yasserqureshi1/ES2C6-Self-Balancing-Robot/Design Project Self Balancing Robot - Group 3.pdf

## ES2C6 Design Project

# Self-Balancing Robot

## Group 3

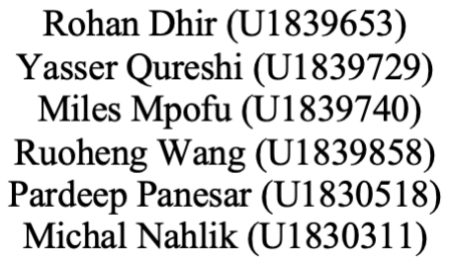
[picture p1: figure]
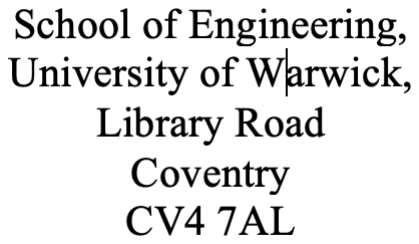
[picture p2: figure]

## December 2019

Table of Contents

## 1. Introduction

1.1Mandate

Our task: design a low cost self-balancing robot which met the following criteria:

1. The ability to balance on both wheels for a minimum of 10 seconds
2. The ability to be fit in our storage box (dimensions 105 x 170 x 295mm) with the wheels removed
3. Can be safely deployed (i.e. not to cause harm by being unstable)
4. Not include any Arduino libraries

1.2Group Aims

1. Innovative design: build on previous successes, adding new features, design and code improvements.
2. Use of Theory: learnt in lectures and additional theories such as the ‘inverted pendulum’.

## 2. Theory

### 2.1 Inverted Pendulum

Our robot was designed with an ‘Inverted Pendulum’ in mind. This describes a system, where an inverted pendulum has to be maintained upright by moving the cart under its centre of mass.

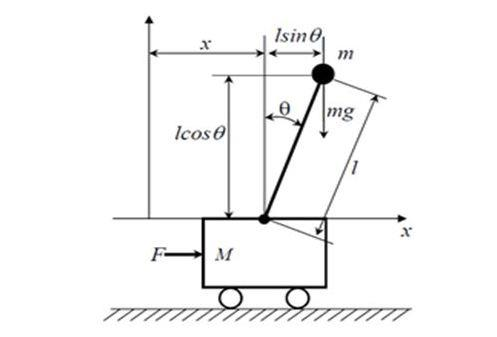
[picture p3: figure]

Figure 1 Theoretical diagram of Self-Balancing Robot

In this system, the pendulum has its centre of mass above the pivot point. The system is naturally unstable and without any help will fall over. In our case the system is a large mass at the end of a pole. The pole is free to rotate around its base, which itself moves in a horizontal plane, perpendicular to the vertical plane of the mass and pole. In the system above, when the pole is offset from its centre point, for example to the left of it, the cart must move to the left to re-centre the centre of mass.

To achieve a state of equilibrium we must control and stabilize the direction and acceleration of the robot. The motion of the robot will depend on the direction of rotation of the wheels and the acceleration will depend upon the angular acceleration of the wheels. Central to balancing our robot is measuring tilt using the IMU, using this feedback to implement closed-loop control. To optimize balance, the centre of mass should be higher relative to the wheel axles since this corresponds to lower angular acceleration and hence slower fall.

2.2Techniques of Sensor Uses

1. Accelerometer: Gives acceleration in multiple axis; x and y calculated using the equation: θ = arctan (Ay/Ax ). However, noise means this method is likely inaccurate.
2. Gyrometer: Calculates the angular velocities across axis. Sometimes has low frequency noise which mean that values are completely wrong.
3. Gyrometer and Accelerometer: Data from both are obtained in an MPU6050 and fused using either a Kalman or a Complementary Filter, resulting in an improvement in the results of both sensors.

2.3DC Motor

DC motors act as continuous actuators to balance the robot, converting electrical energy into mechanical energy through continuous angular rotation to rotate the wheels.

2.4H-Bridge

A H-Bridge controls the direction of the DC motors by switching the polarity of the voltage applied to the load, allowing the motors to run forward or backward.

The H-bridge has four switches, allowing control of the voltage direction. When switches S1 and S4 are closed and S2 and S3 open, a positive voltage is applied across the motor and vice versa to produce a negative voltage.

2.5PID Control

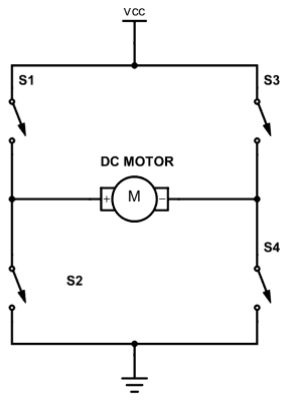
[picture p4: figure]

A PID controller sets the speed of the motors depending on the angle of inclination. It continuously calculates an error value e(t) as the difference between the desired set point and measured process variable and corrects the error based on proportional, integral and derivative terms below:

P: Accounts for present values of the error. For example, if the error is large and positive the control output will also be large and positive.
I: Accounts for past values of the error.
D: Accounts for possible future trends of the error, based on its current rate of change.

The formula using these parameters for PID is below with KP, KI

, KD as non-negative
parameters.
u(t) = KPe(t) + KI ∫ e(t)dt + KP

de
dt

Figure 2 H-Bridge diagram

## 3. Components

3.1List of Components

Table 1

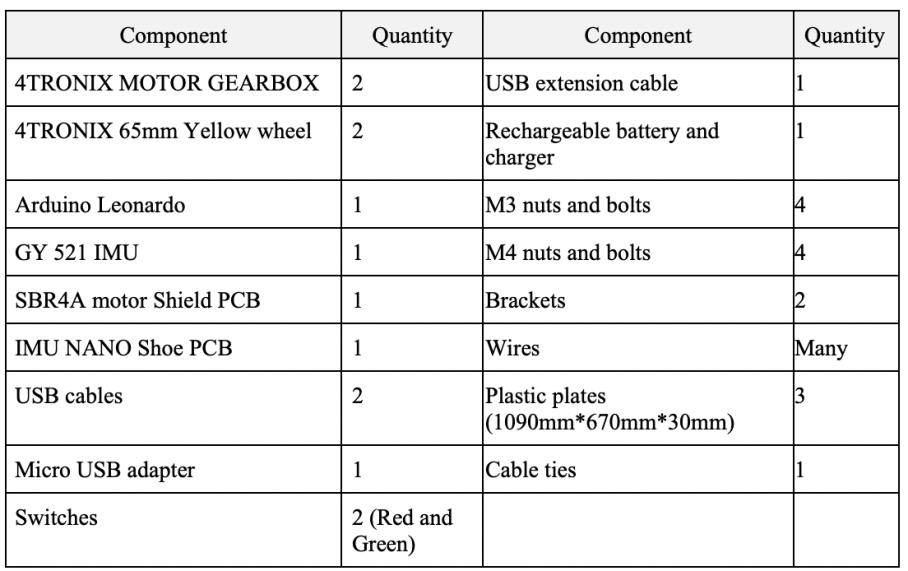
[picture p5: figure]

3.2Components

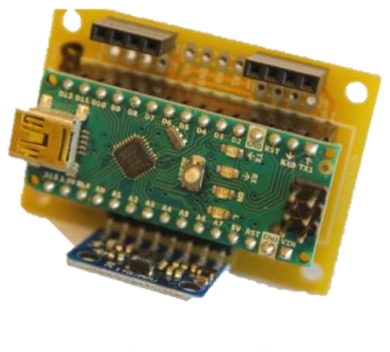
[picture p6: figure]

Figure 3 Accelerometer and Gyroscope

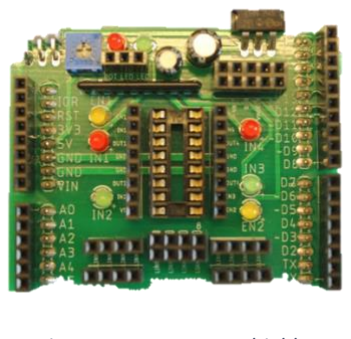
[picture p7: figure]

Figure 4 Motor Protoshield

## 4. Initial Design and Ideas

We initially considered several designs, taking theory into account and focused on creating a feasible yet innovative design.

Our structure was initially divided into 3 layers, with each layer holding a single component, using glue. However, according to the 40 design principles, glue isn’t easy to disassemble, making the entire assembly "one-off", which is not ideal in case of any modification, damage or battery replacement. Therefore, we decided to use fastenings such as nuts, bolts and screws instead, so that we did not compromise on a secure fit.

We used aluminium as the main material for our structure due to its availability as well as its material properties such as its toughness, hardness and rigidity, which would minimise rattling and damage.

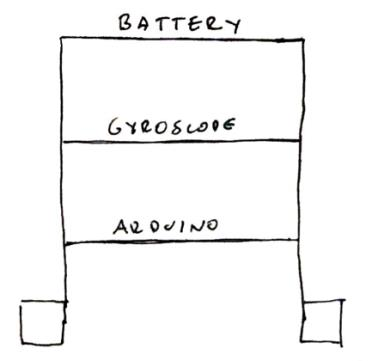
[picture p8: figure]

Figure 5 Initial Design

## 5. Design Improvements and Iterations

Initially, the robot incorporated two horizontal plates mounted on an aluminium tubed design, due to its equal distribution of mass over the axis of rotation. We learned in order to get more accurate accelerometer readings the accelerometer would have to be mounted vertically. As a result, we were forced to rethink our design.

We realised that it would be more efficient to mount the components vertically rather than horizontally as the robot would be more compact and better shielded against damage as well as provide better accessibility and protection. We also designed and printed a 3D plate to hold the battery over the centre of mass. This first iteration was later adjusted to account for switch holders.

During our testing process, we felt our robot was too unstable to function with our Arduino code. We felt that this may be due to the weight distribution of the robot. Although theory tells us that a robot with a higher centre of mass balances better, we sought to remove any excess space between components and trim the length of the aluminium rods by 4cm. This had the immediate effect of a better performing structure.

## 6. Assembly Process

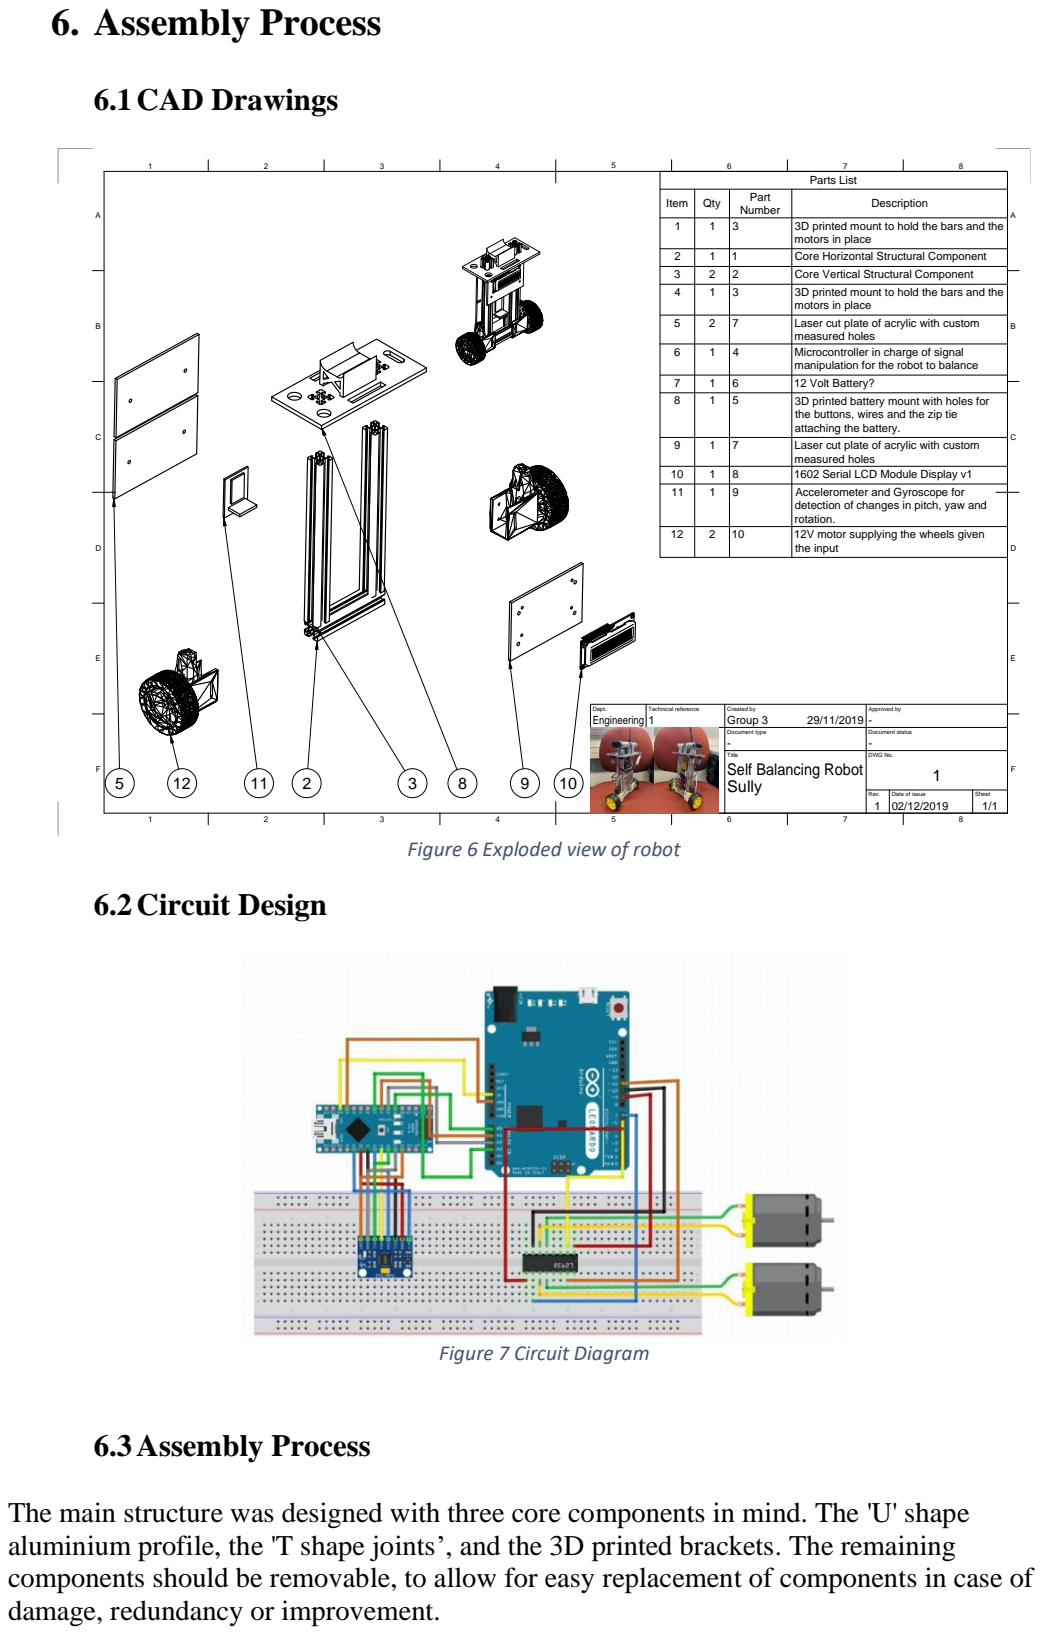
[picture p9: page 7]
6.1CAD Drawings; 6.2Circuit Design; 6.3Assembly Process; Dept.; Technical reference; Created by; Approved by; Document type; Document status; Title; DWG No.; Rev.; Date of issue; Sheet 1 02/12/2019; Sully; 1 Self Balancing Robot; Engineering 1; Group 3; Parts List; Item; Qty; Part Number; Description; 3D printed mount to hold the bars and the motors in place; Core Horizontal Structural Component; Core Vertical Structural Component; Laser cut plate of acrylic with custom; measured holes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

the buttons, wires and the zip tie
attaching the battery.

Figure 6 Exploded view of robot

Figure 7 Circuit Diagram

The main structure was designed with three core components in mind. The 'U' shape
aluminium profile, the 'T shape joints’, and the 3D printed brackets. The remaining
components should be removable, to allow for easy replacement of components in case of
damage, redundancy or improvement.

The U shape is held in place using ‘T-shape joints’ on the rails on the aluminium profiles. Similarly, the acrylic pieces are held together using the rails on the ‘aluminium extrusion bars’ using the ‘t shape joints’ with 4mm screws.

The robot design allows for easy part removal to work on changes and improvements. This was crucial when there were design flaws with the acrylic plates, and we could replace individual plates without disassembling the entire robot. We endeavoured to make the robot as easy to customise as possible. To this effect, we attached the Leonardo plastic motor shield to the structure instead of the Arduino ensuring the Arduino could be easily mounted and unmounted.

## 7. Code and Testing

7.1MPU6050 Testing

The sensor was tested to determine the format of the data and if it functioned as expected. This involves reading values from the GY521 accelerometer and gyroscope. There are 4 different values: yaw, roll, pitch and whether it’s balanced (known as the UP pin)

To read data, the following code is used:

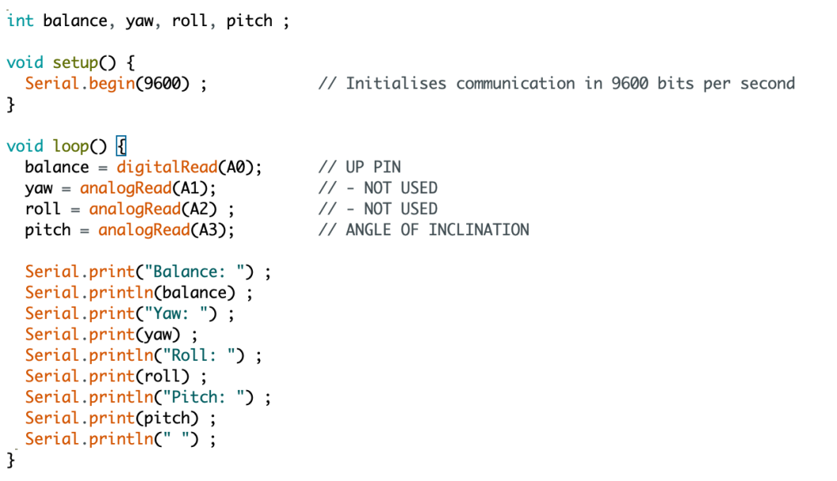
[picture p10: figure]

7.2DC Motor Testing

Prior to any development of PID, tests were conducted as below to determine whether the wheels functioned as expected. Each motor has 3 pins: two inputs (‘INs’) and an enable (‘EN’) pin.

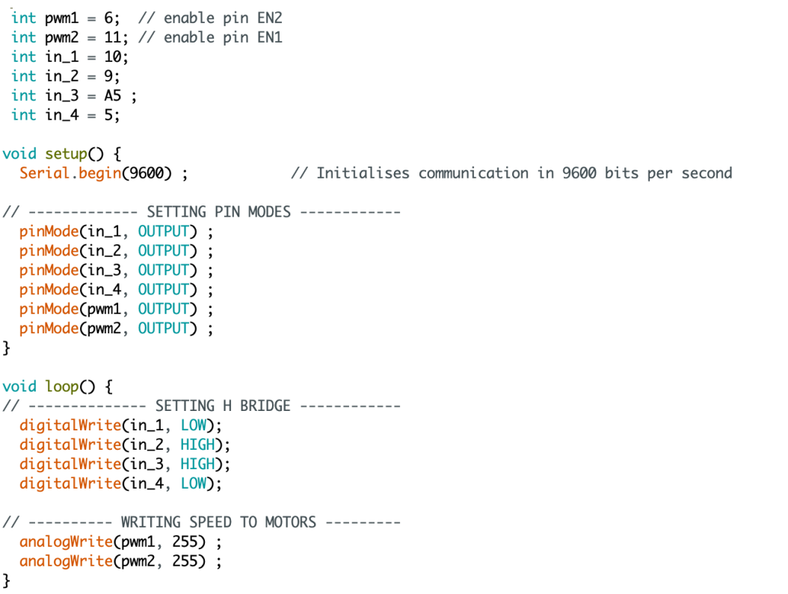
[picture p11: figure]

The test proved successful, as the wheels moved at full speed and changed directions in conjunction with H-bridge initialisation.

7.3Overall Code Testing

The entire code was enhanced using iterative techniques. To get the robot to balance successfully, values such as KP, KI

, KD as well as mapping values were adjusted. The code includes mapping to speed up the motors at small angles and constrain them at mid-high angles, as motors did not adjust well at small angles and to prevent overshoot with higher angles.

## 8. Experimentation and Testing

8.1Surface Testing

To determine the best surface on which our robot would succeed, we needed to test on a variety of surfaces:

Table 2

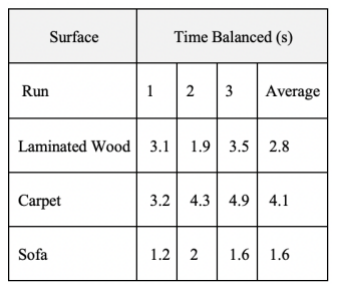
[picture p12: figure]

8.2Drop and Physical Robustness Testing

To justify the adjustments we made to our design; moving the circuit board to the inside of the robot and creating a 3D printed battery holder that could double as fall protection, we endeavoured to test how well the robot would respond to the falls from different heights. This would simulate how much damage the robot would take in case of failure.

Table 3

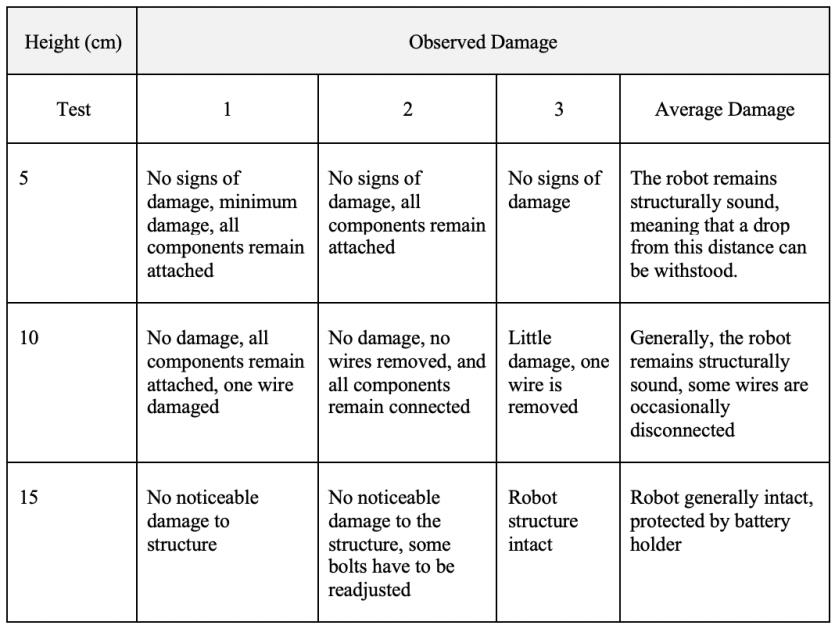
[picture p13: figure]

When dropping from 20cm or higher, cracks began to appear within the acrylic.

8.3Battery Placement and Alignment with Theory

As mentioned earlier within the theory section, placement of the battery is crucial. This determines how much time we have to drive the motors and hence adjust the robot to stay balanced. We aimed to test if these claims remained true and if, by lowering the placement of our batteries, we could get better results.

Table 4

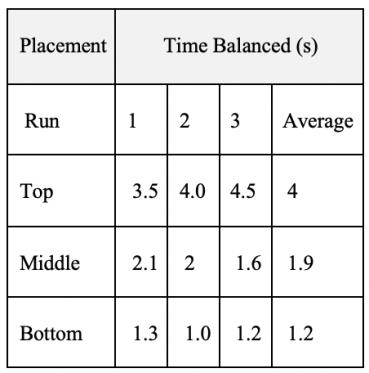
[picture p14: figure]

8.4Overall Testing Results

Our results coincide well with the theory outlined above. When moving the battery, i.e. our centre of mass, the robot performed as expected. Theory states that moving the battery lower would result in a weaker performance, which is what happened. Overall, our robot justified the design decisions made when iterating. This was further reinforced by the drop testing results, which simulated falls we may have should our code fail. Our robot performed best on carpet, as expected, since it provided us with the most grip and traction.

## 9. Conclusions and Final Thoughts

9.1Success of the Robot

Overall, we designed a functional robot that used PID control to balance for a maximum of 4.9 seconds. Although we did not meet the objectives fully, we were still able to successfully demonstrate many of the main concepts; electro-mechanical energy conversion, closed loop control and power electronics. We demonstrated electro-mechanical energy conversion through our successful H bridge operation, closed loop control using a gyroscope and the PID code and power electronics through successful operation of our components.

9.2Potential Improvements to the Process

If we were to complete this task again, we would approach the task in a more organised manner, ensuring that our design was governed more strictly by theoretical knowns, to minimise error. Design wise, we would retrospectively provide the electronic components with more protection by implementing acrylic plates in front of all components, to both protect the robot and improve its aesthetic look. Code and electronics wise we would implement multiple PID controllers. We have currently implemented a single PID controller to control the angle, and by implementing further controls for the speed of the robot, as well as both motors, we feel the robot will perform better.

## 10. References

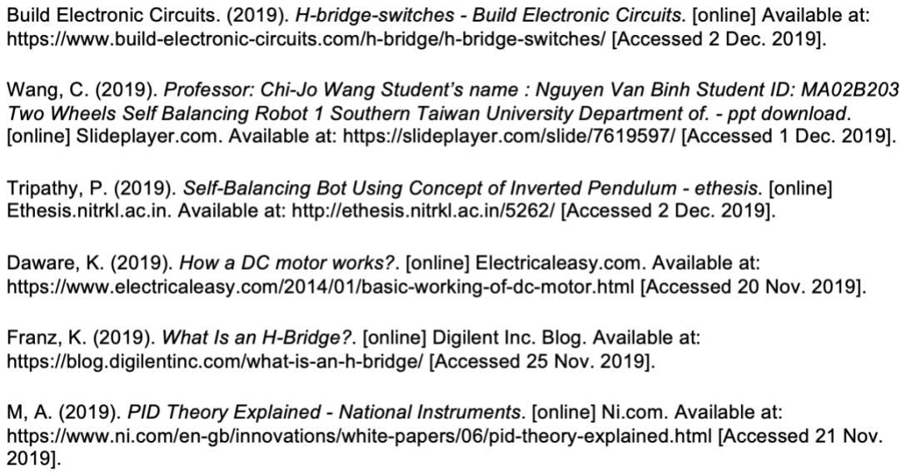
[picture p15: figure]

## 11. Appendix

### 11.1 Overall Code

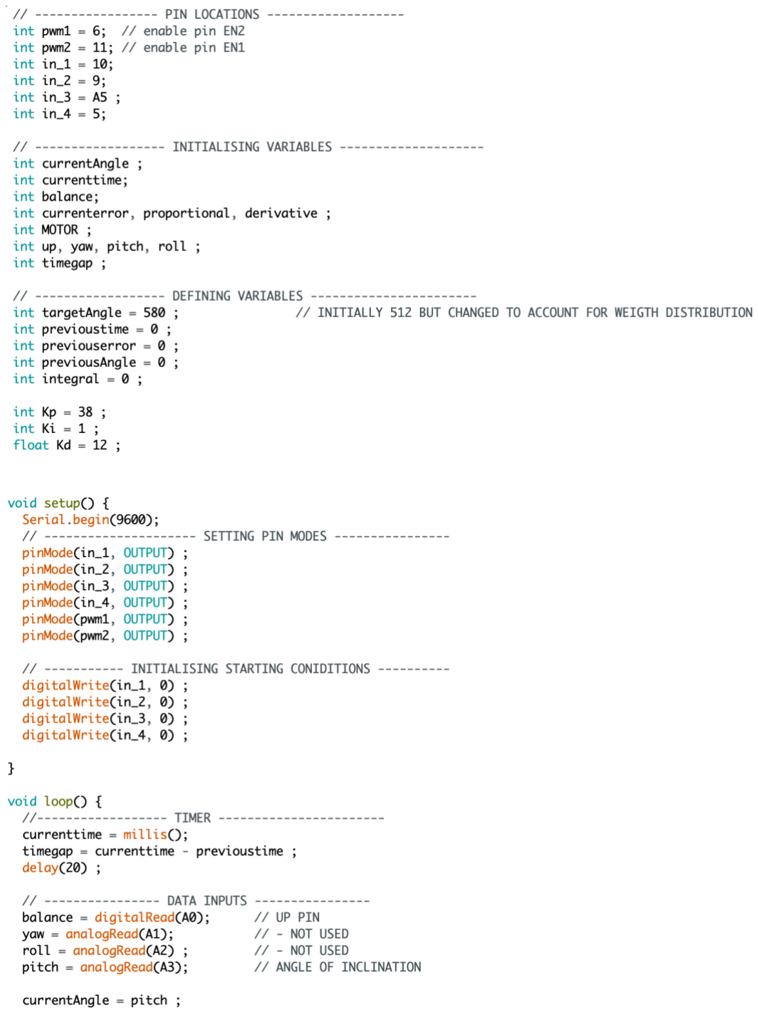
[picture p16: figure]

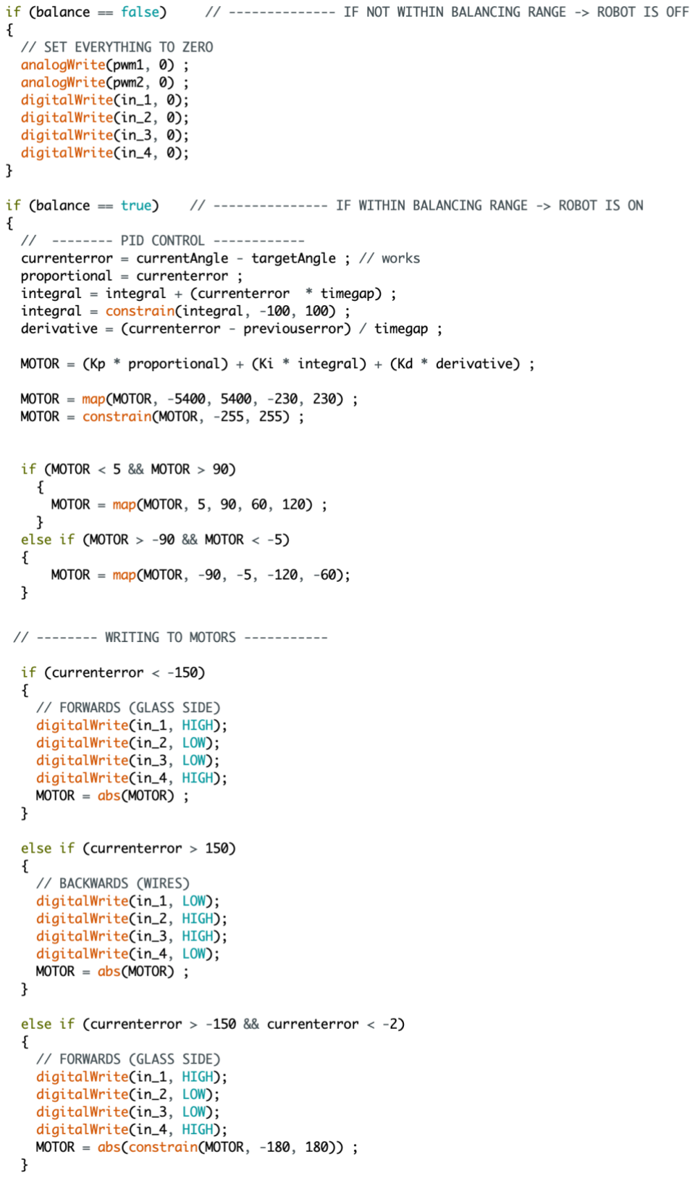
[picture p17: figure]

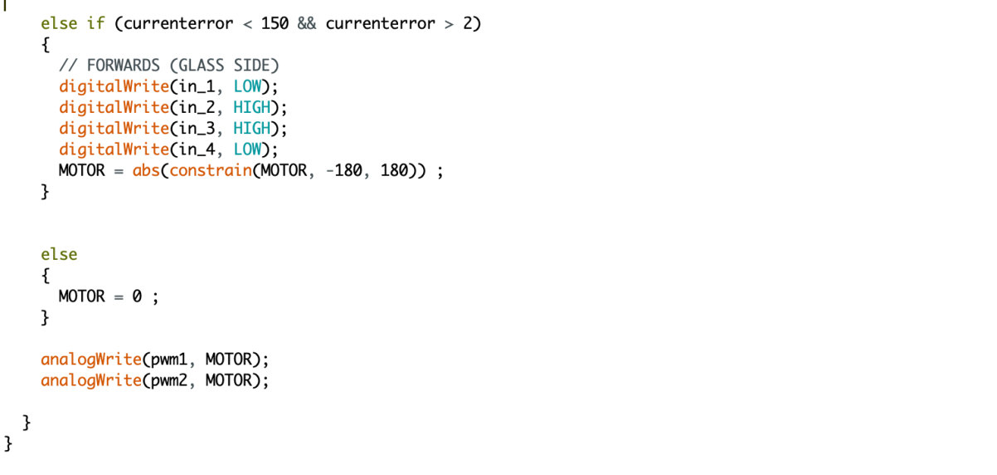
[picture p18: figure]

### 11.2 Render of Initial Idea

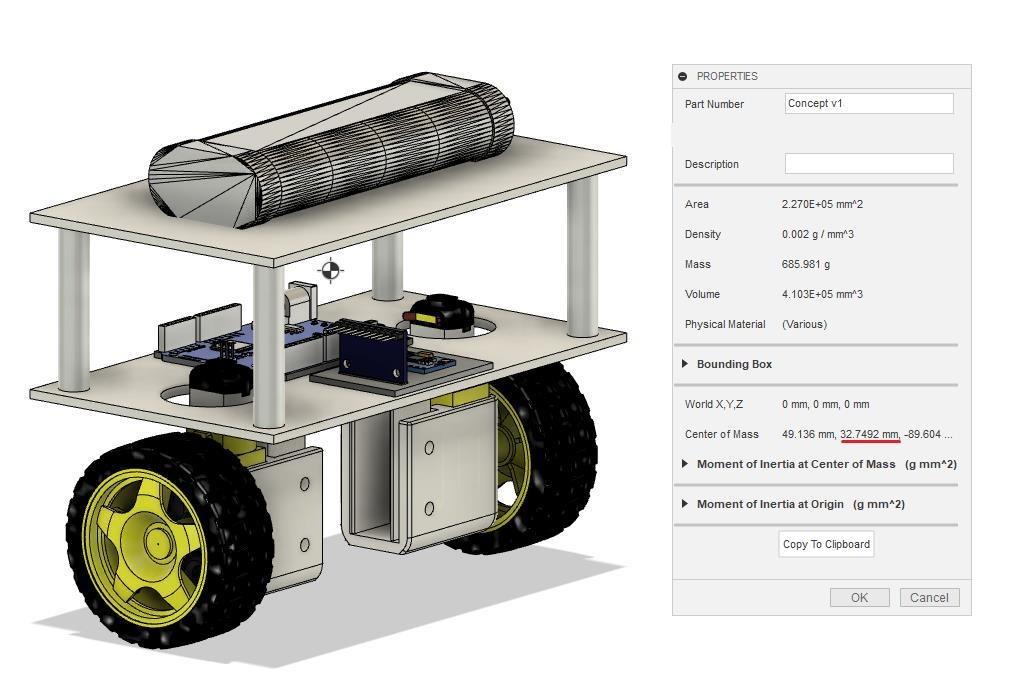
[picture p19: figure]

### 11.3 Render of Final Idea

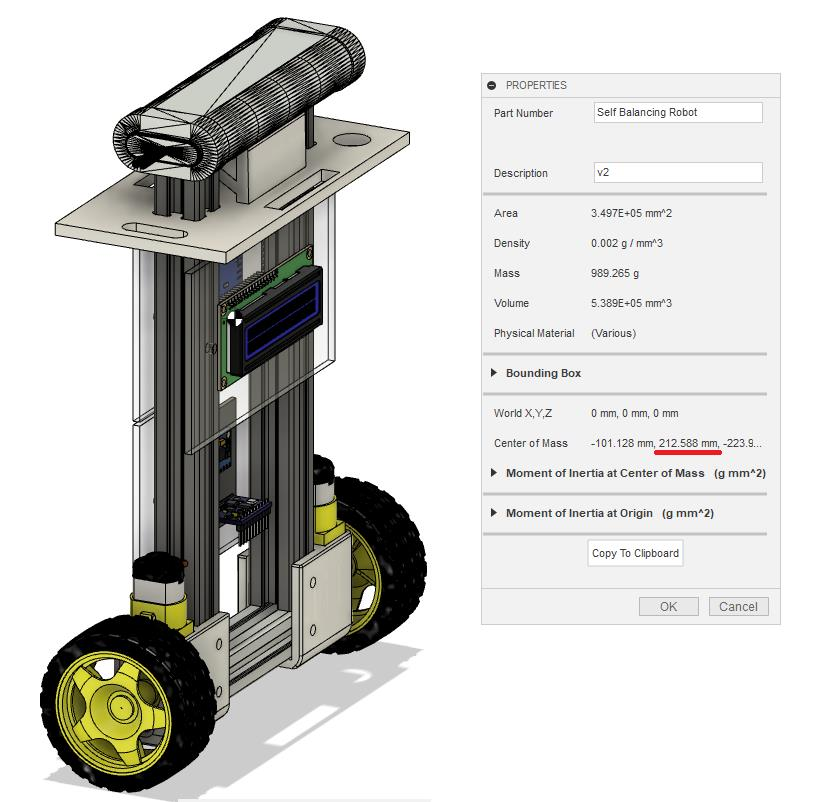
[picture p20: figure]
